RDinh/CENG355NFCSystemsProject/Mechanical/NFCInventoryManagement3DBottom.stl

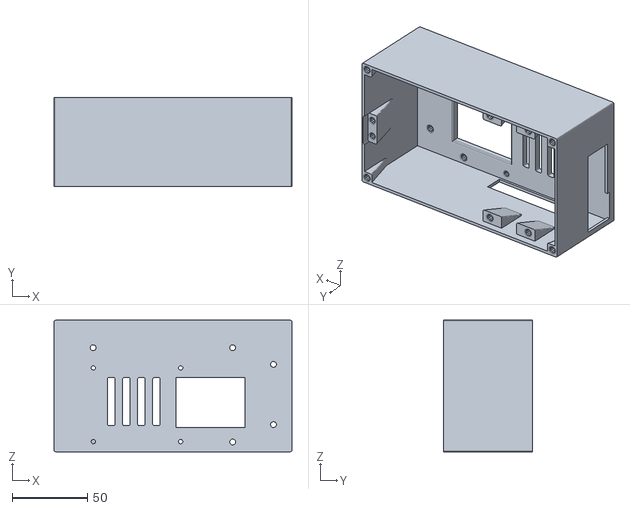
[picture p36: CAD file, 2020-03-23]
Mechanical/NFCInventoryManagement3DBottom.stl
158.1 x 59.0 x 87.5
