RDinh/CENG355NFCSystemsProject/Mechanical/NFCInventoryManagement3DTopCover.stl

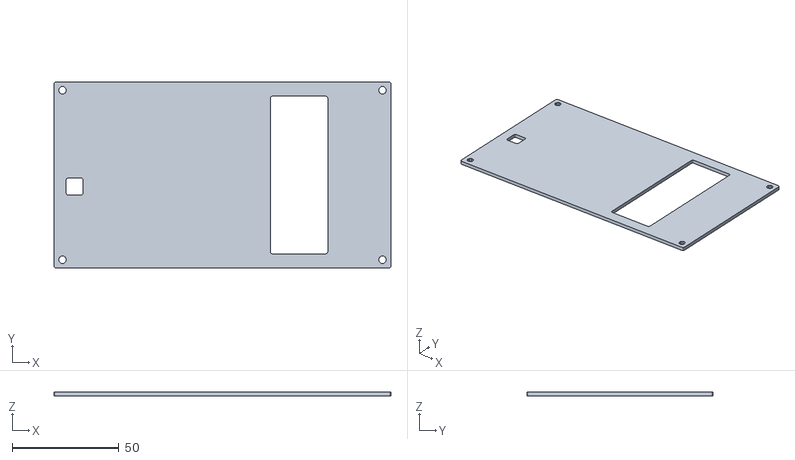
[picture p37: CAD file, 2020-03-23]
Mechanical/NFCInventoryManagement3DTopCover.stl
158.1 x 87.5 x 2.00
