RDinh/CENG355NFCSystemsProject/(commit log)

2020-03-23 STL Files
    [Bottom.stl, TopCover.stl]
2020-03-24 Updated Tech. Report
    [Bottom.stl, TopCover.stl]
2020-04-07 Poster Update
    [NFCInventoryManagement3DBottom.stl, NFCInventoryManagement3DTopCover.stl]
